higgyone/guitar-fx/README.md

# guitar-fx
Creating guitar pedal effects using an FPGA and VHDL. This is a learning experience to understand how to write digital signal processing effects for an FPGA
