higgyone/guitar-fx/hardware/preamp/art/guitar_amp_bolt.png

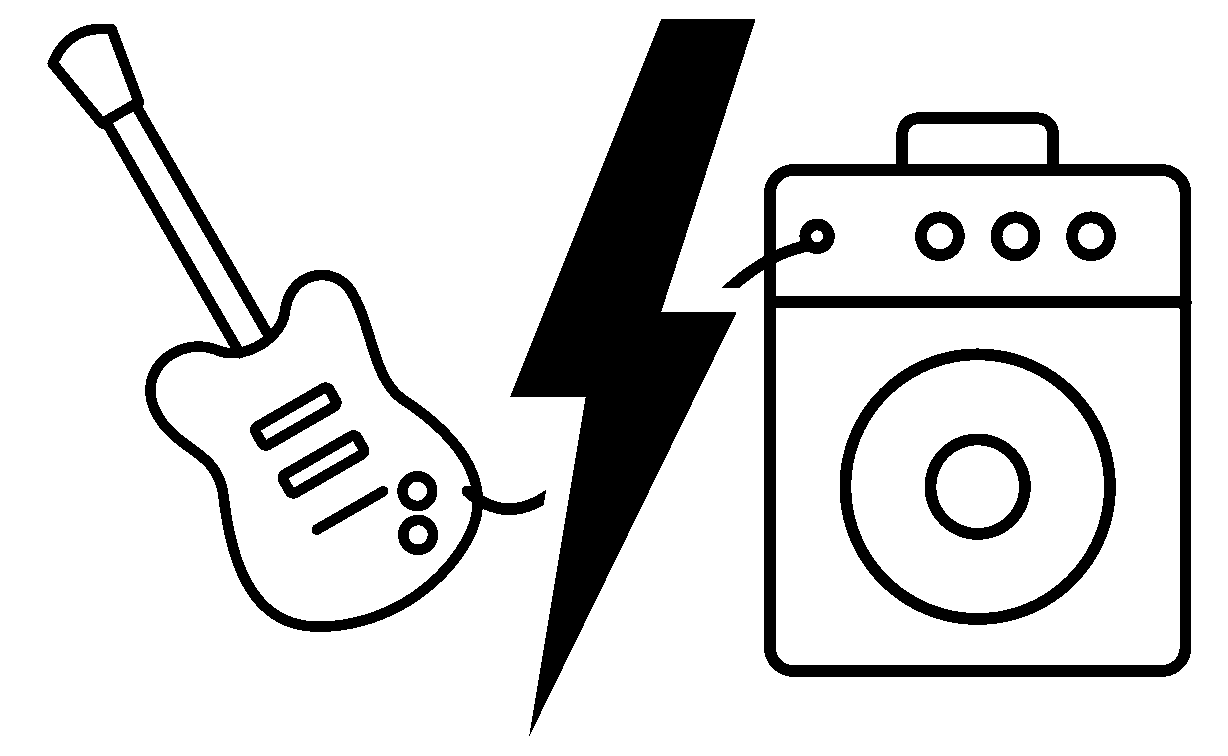
hardware/preamp/art/guitar_amp_bolt.png
