higgyone/guitar-fx/hardware/preamp/bom/bom.csv

Ref | Qty per board | Value | Footprint | Manufacturer | MPN | Notes
U1 | 1 | OPA1642AID | SOIC-8 | Texas Instruments | OPA1642AID | Mouser 595-OPA1642AID, DigiKey; RS 812-2518 back-order
J1 | 1 | DC jack 2.0 mm pin (centre -) | BarrelJack_CUI_PJ-102AH_Horizontal | Same Sky | PJ-102AH
J2 | 1 | 6.35 mm mono switched | Jack_6.35mm_Neutrik_NMJ4HCD2_Horizontal | Neutrik | NMJ4HCD2
J3 | 1 | 3.5 mm stereo | Jack_3.5mm_CUI_SJ1-3523N_Horizontal | Same Sky | SJ1-3523N
D1 | 1 | SS14 40 V 1 A Schottky | D_SMA | Vishay | SS14-E3/61T | Any SMA SS14 (onsemi SS14 at RS)
RV1 | 1 | 50k multi-turn trimmer | Bourns 3296W | Bourns | 3296W-1-503LF
C1 | 1 | 100u 25V | CP_Elec_6.3x7.7 | Nichicon | UCD1E101MCL1GS | Or Panasonic EEE-FK1E101P (RS has it; Mouser/DigiKey out of stock)
C2 | 1 | 100n X7R 50V | 0603 | Yageo | CC0603KRX7R9BB104
C3 | 1 | 10u 25V | CP_Elec_4x5.4 | Panasonic | EEE-FK1E100R
C4 | 1 | 10n C0G 50V | 0402 | Murata | GRM1555C1H103JE01D
C5 C6 | 2 | 3u3 25V | CP_Elec_4x5.4 | Panasonic | EEE-1EA3R3NR | 4 x 5.4 mm S series
C7 | 1 | 100p C0G 50V | 0402 | Murata | GRM1555C1H101JA01D
C8 | 1 | 100p C0G 50V | 0603 | Murata | GRM1885C1H101JA01D
R1 R9 | 2 | 100R 1% | 0603 | Yageo | RC0603FR-07100RL
R10 | 1 | 1k 1% | 0603 | Yageo | RC0603FR-071KL
R7 | 1 | 10k 1% | 0603 | Yageo | RC0603FR-0710KL
R3 R8 | 2 | 100k 1% | 0603 | Yageo | RC0603FR-07100KL
R2 | 1 | 220k 1% | 0603 | Yageo | RC0603FR-07220KL
R4 R5 | 2 | 2M2 1% | 0603 | Yageo | RC0603FR-072M2L
R6 | 1 | 0R link | 0603 | Yageo | RC0603JR-070RL
- | 1 | Pmod I2S2 | - | Digilent | 410-379 | Not on the PCB: ADC/DAC module for the Arty
