higgyone/guitar-fx/hardware/preamp/bom/order_rs.txt

RS Stock No	Quantity	Description
184-0481	1	Digilent Pmod I2S2 (410-379)
812-2518	5	U1 TI OPA1642AID (pack of 5; temporarily out of stock; back-order)
259-6638	5	J3 Same Sky SJ1-3523N (pack of 5)
739-0467	5	D1 onsemi SS14 (pack of 5)
521-9805	2	RV1 Bourns 3296W-1-503LF
537-0499	5	C1 Panasonic EEE-FK1E101P 100u 25V (pack of 5)
537-0483	5	C3 Panasonic EEE-FK1E100R 10u 25V (pack of 5)
886-940	10	C7 Murata GRM1555C1H101JA01D 100p 0402 (pack of 10)
264-4523	25	C8 KEMET C0603C101J5GACTU 100p 0603 (pack of 25)
199-5441	100	R1 R9 Yageo RC0603FR-07100RL (tape of 100)
199-5479	100	R10 Yageo RC0603FR-071KL (tape of 100)
199-5443	100	R7 Yageo RC0603FR-0710KL (tape of 100)
199-5439	100	R3 R8 Yageo RC0603FR-07100KL (tape of 100)
199-5495	100	R2 Yageo RC0603FR-07220KL (tape of 100)
242-4096	100	R4 R5 Yageo RC0603FR-072M2L (tape of 100)
199-5647	100	R6 Yageo RC0603JR-070RL (tape of 100)
