higgyone/guitar-fx/hardware/preamp/fab/preamp_jlcpcb_bom.csv

Comment | Designator | Footprint | Manufacturer | Manufacturer Part | LCSC Part #
OPA1642AID | U1 | SOIC-8 | Texas Instruments | OPA1642AID
PJ-102AH | J1 | BarrelJack_CUI_PJ-102AH_Horizontal | Same Sky | PJ-102AH
SJ1-3523N | J3 | Jack_3.5mm_CUI_SJ1-3523N_Horizontal | Same Sky | SJ1-3523N
SS14-E3/61T | D1 | D_SMA | Vishay | SS14-E3/61T
3296W-1-503LF | RV1 | Bourns 3296W | Bourns | 3296W-1-503LF
100uF | C1 | CP_Elec_6.3x7.7 | ROQANG | RVT1E101M0607 | C72477
100nF | C2 | 0603 | Yageo | CC0603KRX7R9BB104
10uF | C3 | CP_Elec_4x5.4 | ROQANG | RVT1E100M0405 | C72484
10nF | C4 | 0402 | Murata | GRM1555C1H103JE01D
3.3uF | C5,C6 | CP_Elec_4x5.4 | Panasonic | EEE-1EA3R3NR
100pF | C7 | 0402 | Murata | GRM1555C1H101JA01D
100pF | C8 | 0603 | Murata | GRM1885C1H101JA01D
100Ω | R1,R9 | 0603 | Yageo | RC0603FR-07100RL
1kΩ | R10 | 0603 | Yageo | RC0603FR-071KL
10kΩ | R7 | 0603 | Yageo | RC0603FR-0710KL
100kΩ | R3,R8 | 0603 | Yageo | RC0603FR-07100KL
220kΩ | R2 | 0603 | Yageo | RC0603FR-07220KL
2.2MΩ | R4,R5 | 0603 | Yageo | RC0603FR-072M2L
0Ω | R6 | 0603 | Yageo | RC0603JR-070RL
