higgyone/guitar-fx/hardware/preamp/3d/Neutrik_NMJ4HCD2.step

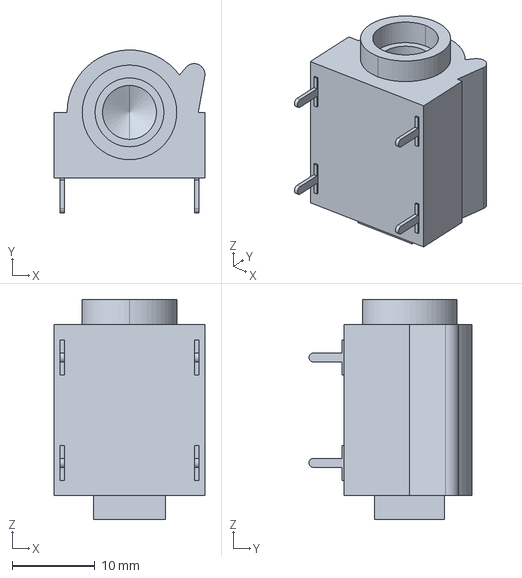
[picture p5: CAD file, 2026-11-08]
hardware/preamp/3d/Neutrik_NMJ4HCD2.step
18.2 x 19.7 x 26.5 mm
