higgyone/guitar-fx/hardware/preamp/3d/CUI_PJ-102AH.step

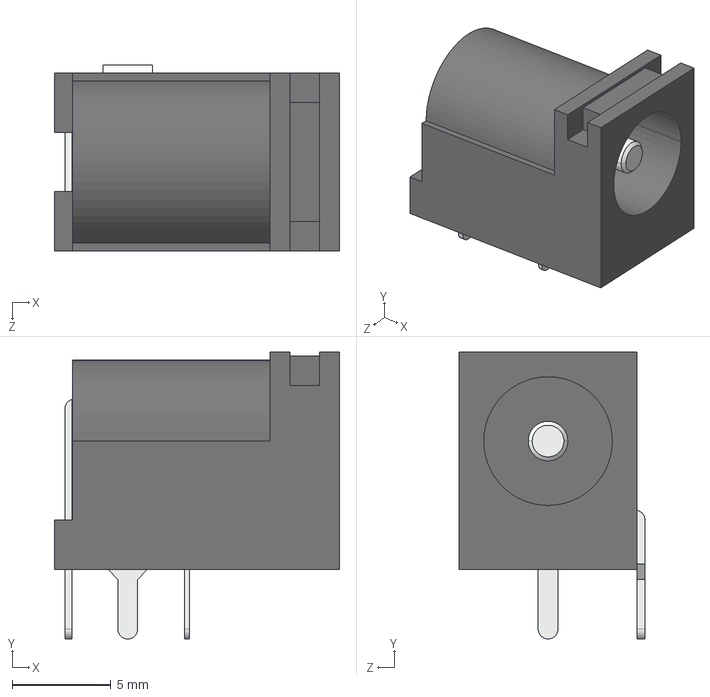
[picture p6: CAD file, 2026-11-08]
hardware/preamp/3d/CUI_PJ-102AH.step
14.4 x 14.5 x 9.40 mm
