higgyone/guitar-fx/docs/vivado_todo.md

# Vivado-PC TODO

Tasks that need Vivado. Tick them off on the Vivado PC and push.

- [x] Installed Vivado version: **2025.2** on the Claude PC. Keep the
  other PC on the same version (a project made by a newer Vivado won't open
  in an older one; the script itself is version-neutral).
- [x] `scripts/create_project.tcl` builds the project (tested 2026-10-30:
  part, VHDL-2008 file types, sim-only testbenches, runtime `all`).
