higgyone/guitar-fx/hardware/preamp/preamp.kicad_pcb

## KiCad design hardware/preamp/preamp.kicad_pcb (2026-11-08)

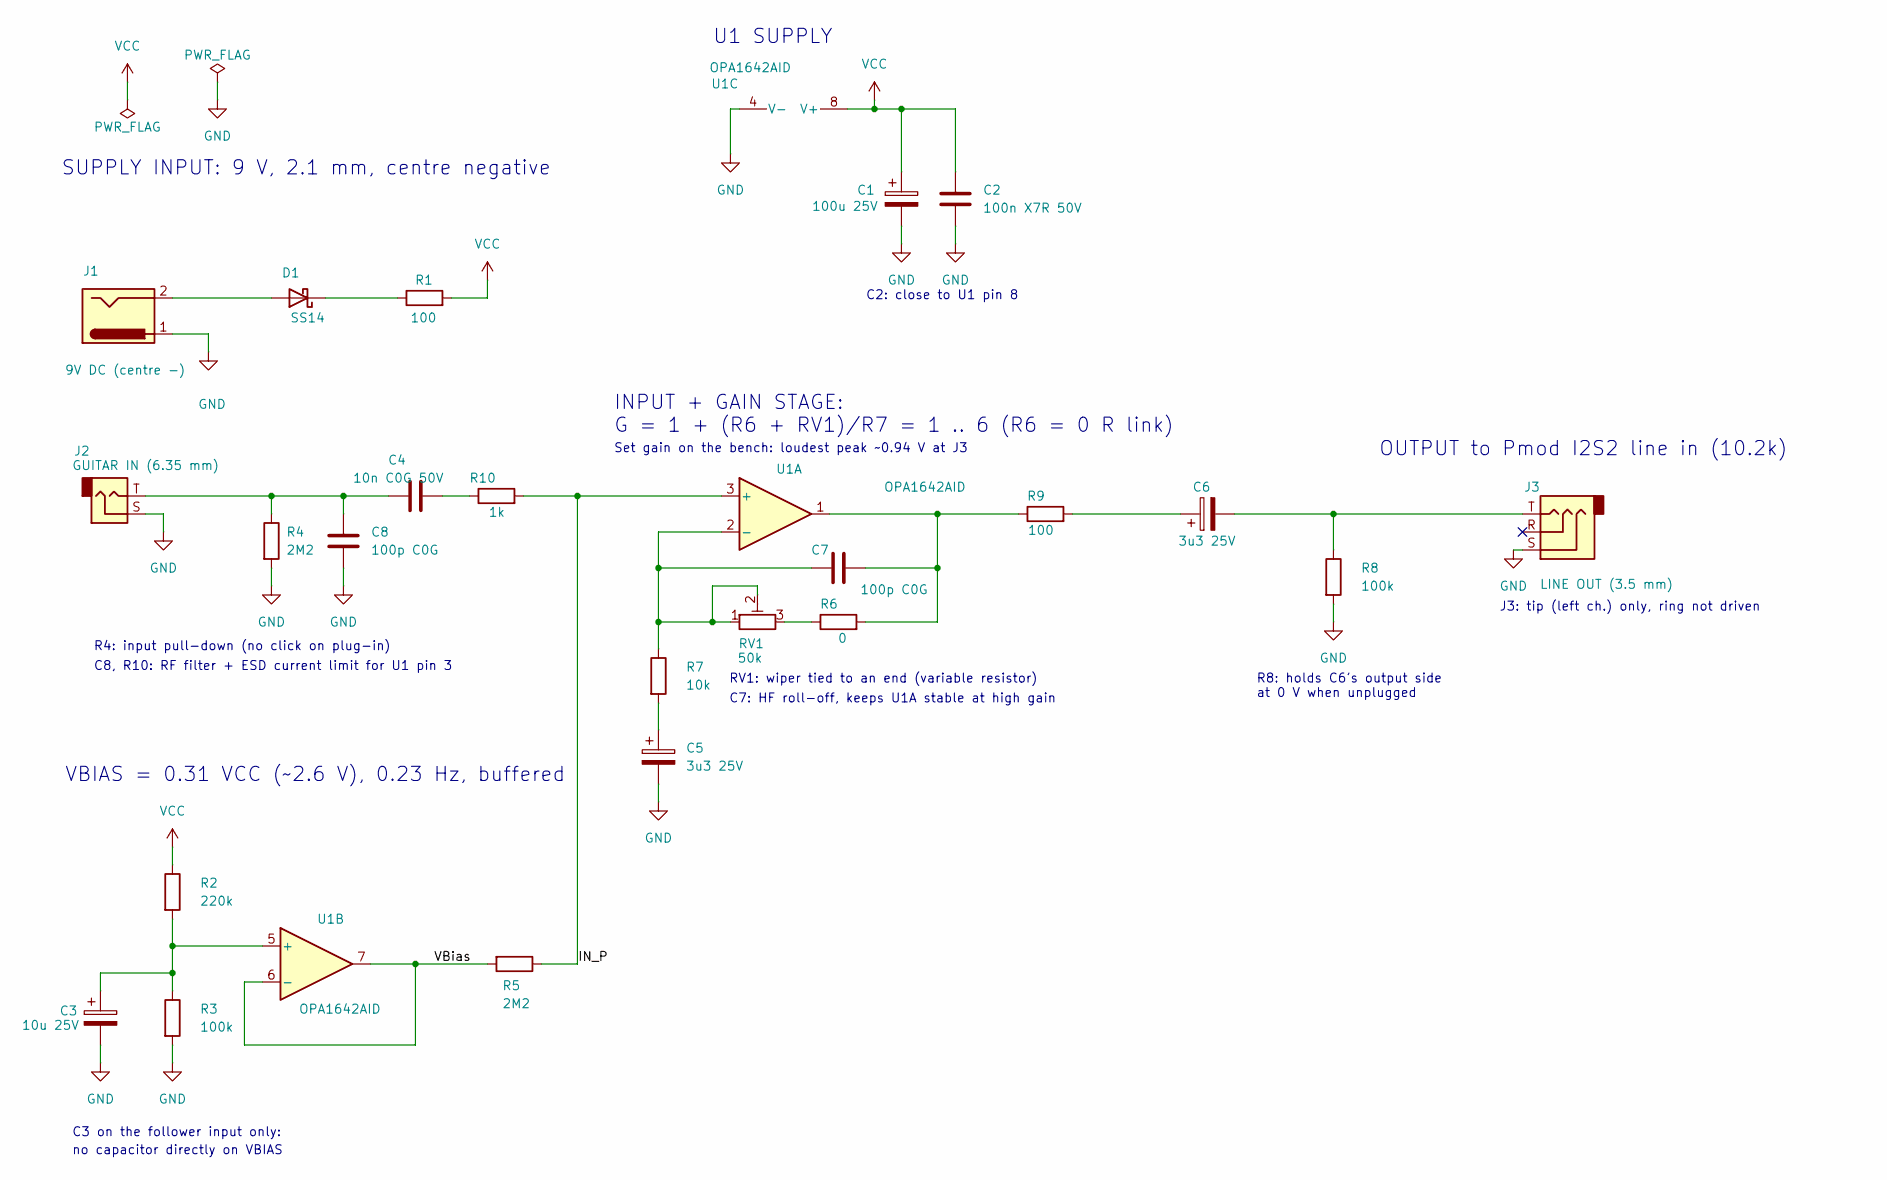
[picture p7: schematic preamp.kicad_sch, Guitar preamp / buffer]

Parts:
C1: 100u 25V; CP_Elec_6.3x7.7
C2: 100n X7R 50V; C_0603_1608Metric_Pad1.08x0.95mm_HandSolder
C3: 10u 25V; CP_Elec_4x5.4
C4: 10n C0G 50V; C_0402_1005Metric_Pad0.74x0.62mm_HandSolder
C5, C6: 3u3 25V; CP_Elec_4x5.4
C7: 100p C0G; C_0402_1005Metric_Pad0.74x0.62mm_HandSolder
C8: 100p C0G; C_0603_1608Metric_Pad1.08x0.95mm_HandSolder
D1: SS14; D_SMA_Handsoldering
J1: 9V DC (centre -); BarrelJack_CUI_PJ-102AH_Horizontal
J2: GUITAR IN (6.35 mm); Jack_6.35mm_Neutrik_NMJ4HCD2_Horizontal
J3: LINE OUT (3.5 mm); Jack_3.5mm_CUI_SJ1-3523N_Horizontal
R1, R9: 100; R_0603_1608Metric_Pad0.98x0.95mm_HandSolder
R2: 220k; R_0603_1608Metric_Pad0.98x0.95mm_HandSolder
R3, R8: 100k; R_0603_1608Metric_Pad0.98x0.95mm_HandSolder
R4, R5: 2M2; R_0603_1608Metric_Pad0.98x0.95mm_HandSolder
R6: 0; R_0603_1608Metric_Pad0.98x0.95mm_HandSolder
R7: 10k; R_0603_1608Metric_Pad0.98x0.95mm_HandSolder
R10: 1k; R_0603_1608Metric_Pad0.98x0.95mm_HandSolder
RV1: 50k; Potentiometer_Bourns_3296W_Vertical
U1: OPA1642AID; SOIC-8_3.9x4.9mm_P1.27mm

Connections:
/IN_P: R5.1, R10.2, U1.3 (+)
/VBias: R5.2, U1.6 (-), U1.7
GND: C1.2, C2.2, C3.2, C5.2, C8.2, J1.1, J2.S, J3.S, R3.2, R4.2, R8.2, U1.4 (V-)
unnamed: C4.1, C8.1, J2.T, R4.1
unnamed: C4.2, R10.1
unnamed: C5.1, R7.2
unnamed: C6.1, R9.2
unnamed: C6.2, J3.T, R8.1
unnamed: C7.2, R6.2, R9.1, U1.1
unnamed: D1.2 (A), J1.2
unnamed: D1.1 (K), R1.1
unnamed: R6.1, RV1.3
unnamed: C7.1, R7.1, RV1.1, RV1.2, U1.2 (-)
unnamed: C3.1, R2.2, R3.1, U1.5 (+)
VCC: C1.1, C2.1, R1.2, R2.1, U1.8 (V+)

Notes on the sheet:
C3 on the follower input only:
R8: holds C6's output side at 0 V when unplugged
SUPPLY INPUT: 9 V, 2.1 mm, centre negative
no capacitor directly on VBIAS
J3: tip (left ch.) only, ring not driven
Set gain on the bench: loudest peak ~0.94 V at J3
INPUT + GAIN STAGE: G = 1 + (R6 + RV1)/R7 = 1 .. 6 (R6 = 0 R link)
R4: input pull-down (no click on plug-in)
C2: close to U1 pin 8
RV1: wiper tied to an end (variable resistor)
OUTPUT to Pmod I2S2 line in (10.2k)
VBIAS = 0.31 VCC (~2.6 V), 0.23 Hz, buffered
U1 SUPPLY
C8, R10: RF filter + ESD current limit for U1 pin 3
C7: HF roll-off, keeps U1A stable at high gain

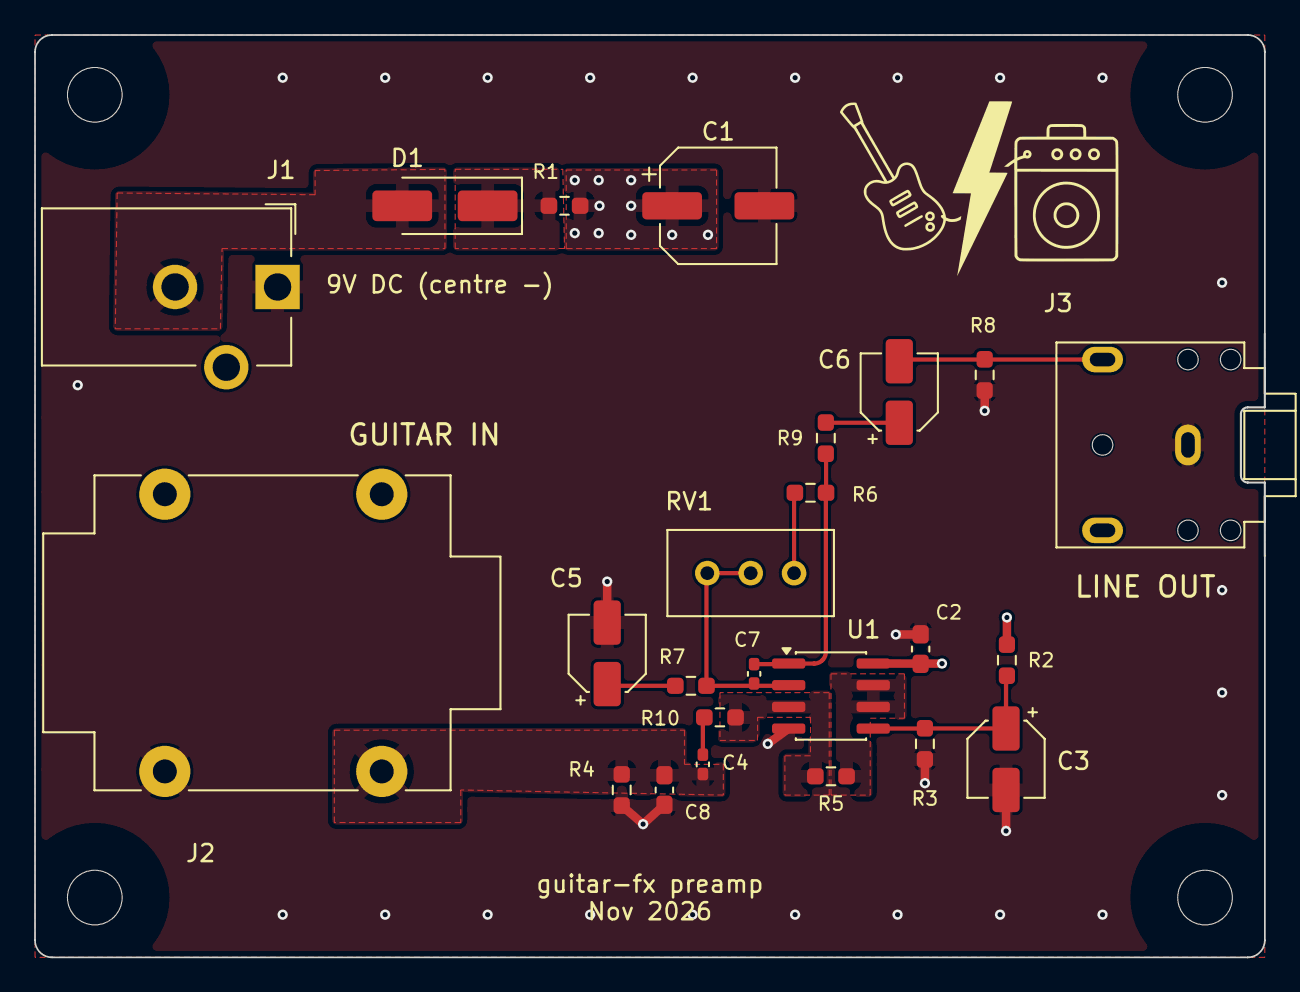
[picture p8: board preamp.kicad_pcb from above]

Board: 4 copper layers, 72.0 x 54.0 mm, 28 parts (0 on the bottom side), 15 nets.

Other parts of the board:
H1, H2, H3, H4: M3; MountingHole_3.2mm_M3
