higgyone/guitar-fx/(commit log)

2026-10-29 Project setup: tooling, spec draft, preamp notes, lesson 1
    - VSG lint (same rules as ULA), pre-commit hook, editorconfig, gitattributes
    - VHDL LS config for rtl/ and sim/
    - Arty A7-35 master XDC
    - CLAUDE.md: mentor mode, two-PC workflow (Vivado project rebuilt by Tcl,
    not tracked), effect interface
    - docs/spec.md: decisions so far (48 kHz, Q1.23, Pmod I2S2, interface) and
    open questions
    - docs/preamp.md: guitar preamp requirements and op-amp selection
    - docs/learning/01_fixed_point.md: fixed-point multiplication lesson
    [Arty-A7-35-Master.xdc]
2026-10-29 Preamp: record ADC/DAC levels from datasheets; keep datasheets local
    - CS5343 ADC full-scale input 0.568 x VA Vpp (1.87 Vpp at 3.3 V)
    - CS4344 DAC full-scale output 0.65 x VA Vpp (2.15 Vpp), 100 ohm out, 3 kohm min load
    - datasheets/ added to .gitignore (vendor PDFs, copyrighted)
2026-10-29 Docs: Pmod I2S2 clock facts and CS5343 grade / source impedance notes
    - spec.md: 48 kHz clocking (MCLK 12.288 MHz, SCLK 64x LRCK), JP1 slave mode,
    I2S bit timing, 784x typo in the reference manual
    - preamp.md: CS5343 commercial vs automotive grade tables; ADC specs need
    source impedance <= 2.5 kohm
2026-10-29 Preamp: Pmod input/output circuits, gain stage, coupling caps, hum notes
    - Pmod line in is a 2:1 divider: full scale at jack ~3.75 Vpp, ~10.2 kohm load
    - Target 0.94 V peak; Rg 10k, Rf 4.7k + 50k trim -> G 1.47..6.47
    - Single-supply biasing explained; C_in 33 nF, C_g / C_out 3.3 uF (polarity noted)
    - No analog 50/60 Hz filter; hum reduced at source, optional digital notch in spec
2026-10-29 Preamp: Vbias divider and buffer, supply input; soft-start block in spec
    - Vbias: 100k/100k + 10 uF (0.32 Hz, -50 dB at 100 Hz, 2.5 s settle),
    spare op-amp half as follower; buffer does not speed settling
    - Supply: 1N5817 series Schottky, 100 ohm + 470 uF RC, 100 nF decoupling,
    25 V caps; ~8.15 V at circuit
    - Op-amp table gains PSRR and quiescent current columns
    - spec: power-up mute / soft start block to hide settle thump
2026-10-30 Preamp: first-draft KiCad 10 schematic from docs/preamp.md
    hardware/preamp: supply input, Vbias divider + buffer, gain stage, output.
    ERC clean; netlist checked against preamp.md. Op-amp is a placeholder
    (OPA1656 symbol, standard dual SOIC-8 pinout).
    Additions: R4 2M2 input pull-down, R8 100k output pull-down (no clicks).
    C_in is 33n C0G 0603 instead of film. Small R/C use 0603 hand-solder
    footprints. Line out drives the tip (left channel) only.
    .gitignore: KiCad local state, backups, lock files. CLAUDE.md: hardware/.
    [preamp.kicad_sch]
2026-10-30 Preamp schematic: wiring drawn and tidied (connectivity unchanged)
    Netlist checked against the previous commit: every net has the same
    pins, no value or footprint changes; only net names differ.
    Known ERC: 2 x power_pin_not_driven on +9V_raw and Vin_protect
    (power symbols on nets fed only by passive pins; needs PWR_FLAG or
    net labels).
    .gitignore: KiCad 10 local history (.history/).
    [preamp.kicad_sch]
2026-10-30 CI: KiCad ERC/DRC check on push and PR
    scripts/kicad_check.sh runs ERC (and DRC with schematic parity once a
    board exists) on every hardware/ project; any error or warning fails.
    Same script runs locally. Workflow uses kicad/kicad:10.0.7 to match the
    dev PCs and uploads the reports.
    Expected to fail until the 2 known ERC errors (+9V_raw, Vin_protect)
    are fixed. CLAUDE.md: how to run it; KiBot noted for fab outputs later.
2026-10-30 CI: install KiCad's default library tables before ERC
    The container has no global sym-lib-table / fp-lib-table, so ERC flagged
    every part as 'library not in the configuration' (56 extra warnings).
2026-10-30 Preamp: C1 470u -> 100u 25V (16 Hz supply filter is enough; VBias has its own); remove the renamed +9V power symbols on +9V_raw / Vin_protect, fixing the two ERC errors
    [preamp.kicad_sch]
2026-10-30 Preamp: footprints for every part (prototype, PCB-mount jacks): SMD electrolytics, Bourns 3296W trimmer, D1 1N5817 -> SS14 (SMA), CUI PJ-102AH / Neutrik NMJ4HCD2 / CUI SJ1-3523N jacks
    [preamp.kicad_sch]
2026-10-30 Preamp: op-amp chosen, U1 = OPA1642AID (OPA1656ID symbol, same dual SOIC-8 pinout); doc lists why and the drop-in alternatives
    [preamp.kicad_sch]
2026-11-01 Preamp: VBias 2.2 V (R2 220k / R3 82k) for OPA1642 input range, R5 2M2 for 1.1 Mohm input, R9 100 ohm output resistor
    The OPA1642 input works only up to V+ - 3.5 V (4.65 V at 8.15 V), so
    mid-supply bias left 0.58 V for guitar peaks. ERC clean; only net change
    is R9 between U1.1 and C6.
    [preamp.kicad_sch]
2026-11-01 Preamp PCB first draft: 4 layers (L1 parts + VCC pour, L2 GND, L3 VCC, L4 GND pour), parts placed, power fanned out to the planes; signal nets not routed yet
    - 72 x 54 mm, M3 corner holes, 1.6 mm stackup with 0.1 mm L1-L2 prepreg
    - preamp.kicad_dru: lets J3's library silkscreen cross its own edge notch
    - preamp.kicad_sch: re-saved by KiCad (formatting only, nets unchanged)
    - docs/preamp.md: PCB section and the no-attenuator output decision
    DRC lists the 21 unrouted signal connections, so CI is red until routing.
    [preamp.kicad_pcb, preamp.kicad_sch]
2026-11-01 Preamp PCB: 9 mm copper keepout round each M3 mounting hole on all four layers, so washers and screws don't short VCC/GND to the chassis
    preamp.kicad_pro: board design defaults written by KiCad when the PCB was opened.
    [preamp.kicad_pcb]
2026-11-01 Preamp review fixes: min gain 1 (R6 0R), VBias ~2.6 V (R3 100k), C7 100p across Rf for stability, R10 1k + C8 100p input RF/ESD filter, C4 10n C0G 0402
    An independent design review found no bugs but three risks: a hot pickup
    clipped even at minimum gain, a feedback pole near the loop crossover at
    high gain, and no input protection. Schematic and PCB updated together
    (new parts placed, R5 moved for R10); ERC clean, DRC only unrouted nets,
    0 parity issues. docs/preamp.md records the reasoning.
    [preamp.kicad_pcb, preamp.kicad_sch]
2026-11-01 Preamp: 3D models for J1 (CUI PJ-102AH) and J2 (Neutrik NMJ4HCD2) via a project footprint library
    KiCad 10 ships without these two STEP files. hardware/preamp/preamp.pretty
    holds copies of the library footprints whose model points at
    ${KIPRJMOD}/3d/, with offset/rotation set by rendering against the pads
    and fab outline. Schematic and board reference preamp:<name>; DRC still
    only reports the unrouted nets. Also: silk VBias label 2.2 V -> 2.6 V.
    [CUI_PJ-102AH.step, Neutrik_NMJ4HCD2.step, preamp.kicad_pcb, preamp.kicad_sch]
2026-11-01 Preamp BOM and order lists for Mouser, DigiKey and RS (Mouser covers everything in stock)
    [bom.csv, order_digikey.csv, order_mouser.csv, order_rs.csv]
2026-11-01 DigiKey order list: add U1 OPA1642AID
    [bom.csv, order_digikey.csv]
2026-11-01 Add U1 OPA1642AID to the Mouser and RS order lists (not already bought)
    [bom.csv, order_digikey.csv, order_mouser.csv, order_rs.csv]
2026-11-01 RS order list as tab-delimited .txt (RS upload accepts txt or xlsx, not csv)
    [order_rs.csv]
2026-11-01 Order lists: two PP3-002A barrel plugs for a bench-supply lead (Mouser, DigiKey)
    [order_digikey.csv, order_mouser.csv]
2026-11-01 gain_stage v1: multiply, truncating slice, 1-clock latency; testbench
    - rtl/gain_stage.vhd (user-written): Q1.23 sample x Q3.15 gain, registered
    Q4.38 product, bits 38..15 -> Q1.23 (truncate, no saturation yet),
    one-clock sample_out_valid
    - sim/gain_stage_tb.vhd: self-checking, latency-tolerant; group 1 (12 exact
    cases) passes in GHDL; groups 2 (saturation) and 3 (rounding) to come
    - CLAUDE.md: fix the two-PC table (laptop has no Vivado; clean Vivado path);
    Python DSP models are written by the user with guidance
    [gain_stage.vhd, gain_stage_tb.vhd]
2026-11-01 WIP gain_stage v2 (saturation); progress log for both PCs
    - docs/progress.md: where the work stopped, next steps, how the user learns
    best. CLAUDE.md points every session at it.
    - sim/gain_stage_tb.vhd: group 2, nine saturation tests (v1 fails them, as
    expected: max x2 wraps to -2)
    - rtl/gain_stage.vhd: user's v2 work in progress (s_overflow and clamp
    constants declared; overflow check and output select still to do).
    Group 2 fails until v2 is finished.
    [gain_stage.vhd, gain_stage_tb.vhd]
2026-11-01 gain_stage v2: saturate on overflow instead of wrapping
    - rtl/gain_stage.vhd (user-written logic): s_overflow when product bits
    41..38 are mixed; clamp to Q1.23 max/min, direction from bit 41 (the true
    sign). All 21 testbench cases pass (12 exact + 9 saturation), latency 1.
    Header and line comments added by Claude on request.
    - docs/progress.md: v2 done; next is v3 rounding.
2026-11-02 gain_stage v3: round to nearest before saturating
    - rtl/gain_stage.vhd (user-written logic): c_round (bit 14 = half an output
    LSB) added after the product register; overflow check and slice use the
    rounded value. Comments updated by Claude on request.
    - sim/gain_stage_tb.vhd: group 3, eight rounding cases incl. a value that
    rounds over +1.0 and must saturate. All 29 cases pass, latency 1.
    - docs/progress.md: gain stage complete; next-step options.
2026-11-02 soft_start: design notes and entity (WIP)
    - docs/progress.md: soft start design (option B wraps gain_stage, 144,000
    sample mute, 2,048 sample ramp with step 16, state table), next step
    - rtl/soft_start_stage.vhd (user-written): soft_start entity with
    g_mute_length and g_ramp_bits generics; architecture not started
2026-11-03 soft_start: mute, ramp and run around gain_stage; testbench
    - rtl/soft_start.vhd (user-written logic): MUTE -> RAMP -> RUN state machine
    stepping on sample_in_valid, sample counter, ramp gain counter x
    2^(15 - g_ramp_bits), gain_stage instance. Ramp maths comment by Claude.
    Replaces rtl/soft_start_stage.vhd (renamed).
    - sim/soft_start_tb.vhd: tiny generics; checks mute, ramp, run and reset.
    Passes in GHDL.
    - rtl/gain_stage.vhd: s_rounded initial value (no 0 ms metavalue warning).
    - docs/progress.md: soft start complete; next-step options.
    [gain_stage.vhd, soft_start.vhd, soft_start_tb.vhd]
2026-11-04 Python model and hear-it pipeline for gain_stage; Ruff for Python
    - model/gain_stage_model.py, model/run_gain_stage.py (user-written): bit-exact
    model (scalar + numpy) and a one-command run: WAV -> text -> GHDL ->
    compare with the model (0 mismatches on 240,000 samples) -> WAV.
    - model/wav_io.py, model/make_test_signal.py, sim/gain_stage_file_tb.vhd:
    WAV/text plumbing, synthetic plucked-guitar test signal, file-streaming
    testbench.
    - model/requirements.txt: project venv packages.
    - ruff.toml + pre-commit hook: Ruff lint (incl. docstrings and type hints)
    and format for Python. Type hints and Args/Returns docstrings added.
    - CLAUDE.md, docs/progress.md: Python setup and state.
2026-11-04 I2S design groundwork; run_gain_stage gain back to 2.0
    - docs/i2s.md: I2S protocol, Pmod I2S2 pin map on JA (JP1 = SLV), single
    98.304 MHz clock domain, 11-bit counter giving MCLK/SCLK/LRCK (bits
    2/4/10) and strobes (15/31/2047), i2s_clocks port list, block plan.
    - docs/progress.md: next step is the user writing rtl/i2s_clocks.vhd.
    - model/run_gain_stage.py (user): GAIN = 2**16 (2.0), matching its comment.
2026-11-05 i2s_clocks: MCLK/SCLK/LRCK from an 11-bit counter, sclk_rise/sclk_fall/frame_start strobes; self-checking testbench (passes in xsim)
2026-11-05 i2s_rx: left-channel I2S receiver (24-bit, MSB first, I2S delay bit skipped); self-checking testbench with a CS5343 model (passes in xsim)
    [i2s_rx.vhd, i2s_rx_tb.vhd]
2026-11-05 i2s_tx: I2S transmitter (24-bit MSB first, same sample in both slots, double-buffered); self-checking testbench with a CS4344 model (passes in xsim)
2026-11-05 I2S loopback testbench: ADC model -> i2s_rx -> i2s_tx -> DAC model, samples out unchanged one frame later (passes in xsim)
2026-11-06 I2S top level: Clocking Wizard 98.304 MHz (from create_project.tcl), reset synchroniser, i2s_clocks -> rx -> soft_start -> tx on Pmod JA; XDC pins; system testbench top_tb (passes in Vivado with the 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
    [Arty-A7-35-Master.xdc, top.vhd, top_tb.vhd]
2026-11-06 top: output gain stage after soft_start, g_gain generic (default 1024 = 1/32 = -30.1 dB for the PC mic input); top_tb uses gain 1.0
2026-11-06 tone_gen: 1 kHz -20 dBFS test tone (48-sample table) and top's g_test_tone switch to send it straight to the DAC; tone_gen_tb; top_tb sets g_test_tone false
2026-11-07 docs: priorities (PCB and effects now; QSPI flash boot and UART control later), board test log for 2026-11-06, spec Q5.2 note
2026-11-07 Preamp PCB placement rev 2: U1 next to the guitar jack, short pin-2 node, GND plane vias at the SMD GND pads, VCC as a B.Cu L-pour kept clear of U1 and the input (x >= 152), In2 now GND; docs/preamp.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
    [preamp.kicad_pcb]
2026-11-07 Preamp PCB routed: all nets connected, DRC clean apart from silkscreen; small signal pours on the input, pin 3 and VBias nodes; power net class and track size presets
    [preamp.kicad_pcb]
2026-11-07 Preamp PCB: guitar-amp-lightning logo on the silkscreen (art in hardware/preamp/art), silkscreen labels tidied, scrap track segments removed (all tracks 0.25 or 0.5 mm); DRC clean
    [preamp.kicad_pcb]
2026-11-07 Preamp fab files for JLCPCB: Gerbers, drill files and upload zip (hardware/preamp/fab, with order settings); stackup set to JLC04161H-3313 with ENIG; footprints checked against the datasheets, J3 slo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
    [preamp-B_Cu.gbl, preamp-B_Mask.gbs, preamp-B_Silkscreen.gbo, preamp-Edge_Cuts.gm1, preamp-F_Cu.gtl, preamp-F_Mask.gts, preamp-F_Silkscreen.gto, preamp-NPTH-drl_map.gbr]
2026-11-08 Preamp: JLCPCB assembly files (BOM + pick and place), as ordered
    - fab/make_jlc_assembly.py builds preamp_jlcpcb_bom.csv and
    preamp_jlcpcb_cpl.csv from kicad-cli's preamp-pos.csv and bom/bom.csv,
    and fails if the board and the BOM disagree.
    - BOM comments in JLCPCB's value style (100Ω, 2.2MΩ, 100nF), UTF-8.
    - C1 / C3: LCSC substitutes C72477 / C72484 (same value, voltage, case).
    - J2 (NMJ4HCD2) not at LCSC: left out of both files, hand-soldered.
    - U1 rotation +270 (SOIC-8 zero angle differs at JLCPCB).
    - J3 footprint: cleared exclude_from_pos_files / exclude_from_bom (from
    KiCad's library) so it appears in position and BOM exports.
    [preamp.kicad_pcb, preamp_jlcpcb_bom.csv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]
2026-11-08 hard_clip_stage (effect #2, hard clip) + testbench; guitar output measured
    - rtl/hard_clip_stage.vhd: clamps each Q1.23 sample to +/- threshold,
    standard effect interface, 1 clock latency (clamp before the register).
    threshold must be positive (0x800000 negates to itself).
    - sim/hard_clip_stage_tb.vhd: self-checking, 22 checks (Q1 table, edges
    +/- 1 LSB, max and zero threshold, hold, reset). Passes in xsim.
    - docs/preamp.md: guitar peak 205 mV (both pickups, 5 strums); gain
    designed for 0.3 V for headroom: G = 3, RV1 = 20 kOhm.
    [hard_clip_stage.vhd, hard_clip_stage_tb.vhd]
2026-11-08 top: distortion (drive + hard clip) with an SW0 bypass
    - drive_gain_stage (gain_stage, g_drive_gain) -> clip_stage
    (hard_clip_stage, g_threshold), between i2s_rx and soft_start.
    Defaults x1.0 / max threshold.
    - distortion_sw (SW0) through a two-flip-flop synchroniser (starts '0',
    bypassed) selects the clipped or the dry signal; sample and valid
    switch together.
    - Sample / valid signals renamed after the block that drives them
    (s_rx_sample, s_drive_sample, s_clip_sample, s_fx_sample, s_soft_sample,
    s_gain_sample). Header diagram updated.
    - top_tb: distortion_sw held at '0' (bypass); passes in xsim (exact
    pass-through, 36 frames).
    SW0's XDC pin is not set yet.
    [top.vhd, top_tb.vhd]
2026-11-08 Distortion on the board: SW0 pin, drive x2.0 / threshold 0.125, bench results
    - XDC: SW0 (A8) -> distortion_sw.
    - top: g_drive_gain default x2.0, g_threshold 0.125, sized for the guitar
    through the preamp at G = 3; header explains the choice.
    - Bench test on the Arty (USB adapter, 1 kHz): bypass unchanged
    (-28.8 dB); distortion +6.1 dB below the clip, clipping from ~-12 dBFS
    in, odd harmonics and squaring above it. Routed WNS +2.549 ns.
    - docs/progress.md: results; docs/img/distortion_vs_clean.png: clean vs
    distortion waveforms and spectra at -15 / -9 / -3 dBFS.
2026-11-08 top_tb: distortion-on run (generic g_distortion)
    - g_distortion = false (default): SW0 down, exact pass-through as before.
    - g_distortion = true: SW0 up, drive x2.0 / threshold 0.125 passed to top;
    every frame after the ramp must equal expected_out(input): the drive
    rounded and saturated as gain_stage does, then clipped. Coverage: frames
    at +threshold, -threshold and unclipped.
    - Test pattern gains small samples (under the clip, and exactly on it).
    - Both runs pass in xsim (bypass 36 frames; distortion 36 frames: 15 at
    +threshold, 14 at -threshold, 5 unclipped). A threshold 1 LSB high in
    top makes the distortion run fail on the first clipped frame.
    [top_tb.vhd]
2026-11-08 soft_clip_stage (effect #2, soft clip, tanh lookup table) + testbench
    - rtl/soft_clip_stage.vhd: out = tanh(k * in) / tanh(k), k = g_drive
    (default 3.0). 1024-entry table of the positive half (tanh is odd),
    built at elaboration with math_real; registered read (block RAM).
    Negative inputs are inverted in (not x, no -1.0 special case) and the
    table value inverted back. Address = bits 22..13. Latency 1 clock.
    - sim/soft_clip_stage_tb.vhd: expected values from math_real's tanh, not
    from the DUT. 2062 samples: spot values, all 1024 entries both signs,
    odd symmetry, monotonic, small-signal gain ~ k / tanh(k), hold, reset.
    Passes in xsim. Using s_neg (registered) instead of sample_in(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
    [soft_clip_stage.vhd, soft_clip_stage_tb.vhd]
2026-11-08 top: soft clip on SW1 (SW0 on/off, SW1 soft/hard)
    - soft_clip (soft_clip_stage, g_soft_drive, default 3.0) fed straight from
    i2s_rx; a gain_stage in front would hard-clip at full scale.
    - soft_clip_sw (SW1) with its own two-flip-flop synchroniser. Distortion
    mux: SW0 off -> dry; SW0 on -> SW1 picks soft ('1') or hard ('0'). Last
    branch unconditional (no latch).
    - XDC: SW1 (C11) -> soft_clip_sw.
    - top_tb: g_distortion replaced by g_mode (0 dry, 1 hard, 2 soft); soft
    clip expected values from math_real's tanh. All three modes pass in
    xsim (36 frames exact each).
    [Arty-A7-35-Master.xdc, top.vhd, top_tb.vhd]
2026-11-08 progress: soft clip on the board (gain 9.5 dB over bypass = k/tanh(k), H3 -40 dB at the bench's top level), plot vs clean and hard clip
2026-11-09 soft_clip_stage: linear interpolation between table entries (1025 entries, 3-stage pipeline: dual ROM read, gap x f in a DSP, add), no staircase or dead zone; TBs expect the interpolated values
2026-11-09 progress: soft-clip interpolation on the board (gain flat to -42 dBFS, low-level THD halved), strum listening test, timing TODO for the ROM -> subtract -> DSP path
2026-11-09 Boot from the QSPI flash: quad SPI, 33 MHz, compressed bitstream (XDC); .bin written with every .bit (create_project.tcl); docs/qspi_boot.md with the flash update steps
2026-11-13 progress: tremolo on the board (5.00 Hz, depth 0.500, peak = bypass level), bench plot
2026-11-13 uart_tx and testbench; UART design doc
    - rtl/uart_tx.vhd (user-written): 8N1 transmitter, 10-bit shift register
    loaded '1' & data & '0', right shift filling '1', g_clks_per_bit (853 =
    115 200 baud at 98.305 MHz), busy, valid ignored while busy.
    - sim/uart_tx_tb.vhd: PC receiver model; bytes, bit timing, busy length,
    ignored valid, back-to-back, idle. Passes in GHDL.
    - docs/uart.md: UART groundwork (frame, pins, baud error, synchroniser,
    blocks, protocol options, uart_tx design).
    - docs/progress.md: UART state; corrected Vivado path.
    [uart_tx.vhd, uart_tx_tb.vhd]
2026-11-13 uart_tx: header and port/signal comments (Claude, on request)
